manugp93/Nema_Clock/Media/IMG_20180118_104231.jpg

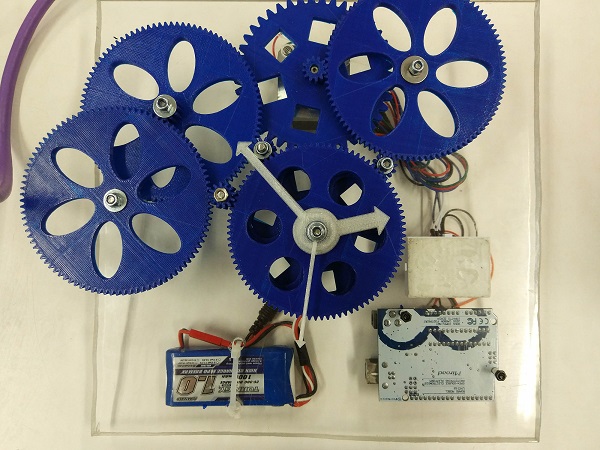
Media/IMG_20180118_104231.jpg
