manugp93/Nema_Clock/STL/12dientrs.stl

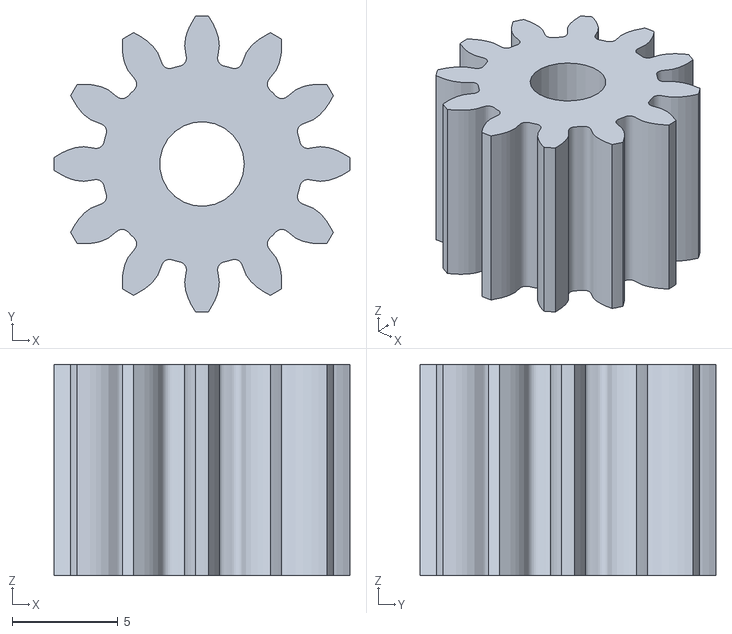
[picture p2: CAD file, 2018-02-03]
STL/12dientrs.stl
14.0 x 14.0 x 10.0
