manugp93/Nema_Clock/STL/90d.stl

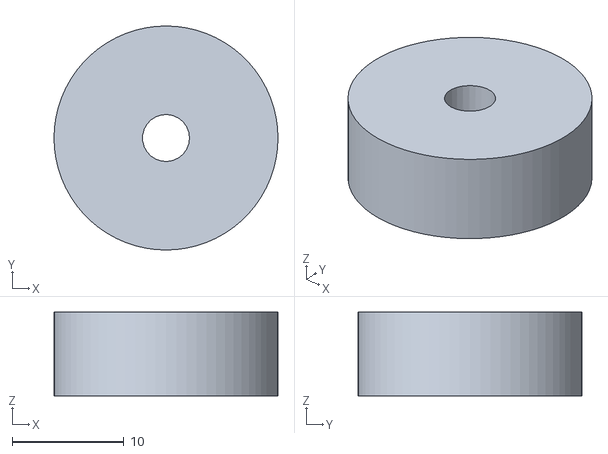
[picture p3: CAD file, 2018-02-03]
STL/90d.stl
20.0 x 20.0 x 7.50
