manugp93/Nema_Clock/STL/96dientes.stl

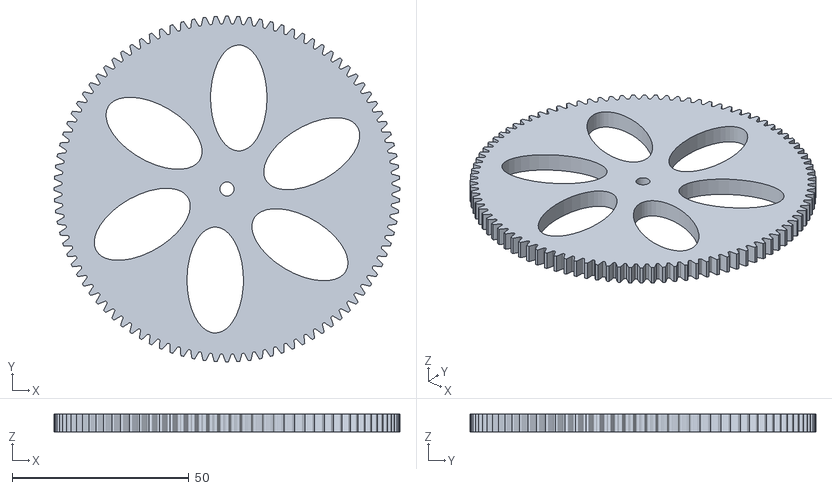
[picture p4: CAD file, 2018-02-03]
STL/96dientes.stl
98.0 x 98.0 x 5.00
