manugp93/Nema_Clock/STL/minutos.stl

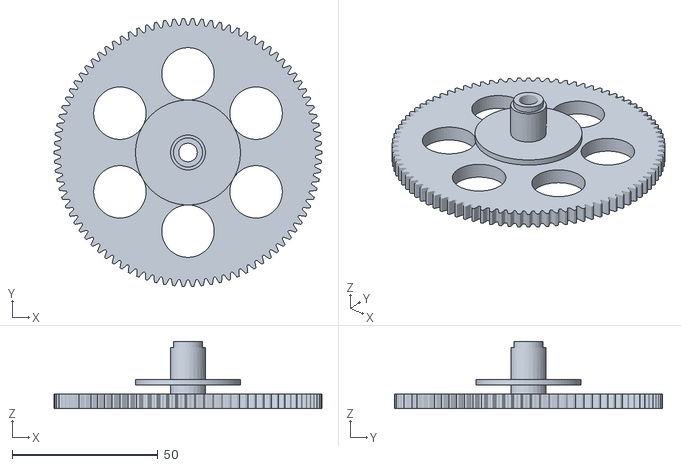
[picture p5: CAD file, 2018-02-03]
STL/minutos.stl
92.0 x 92.0 x 23.0
