manugp93/Nema_Clock/STL/nemagear.stl

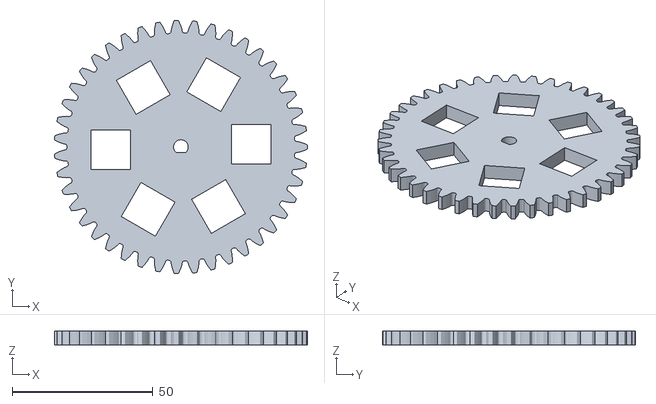
[picture p6: CAD file, 2018-02-03]
STL/nemagear.stl
89.9 x 90.0 x 5.00
