manugp93/Nema_Clock/STL/pivote2.stl

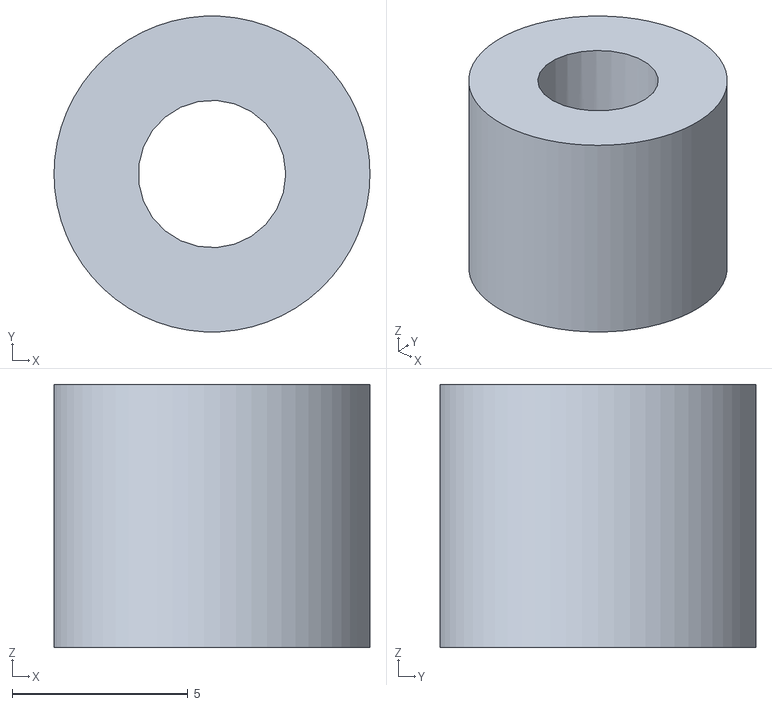
[picture p7: CAD file, 2018-02-03]
STL/pivote2.stl
9.00 x 8.99 x 7.50
