manugp93/Nema_Clock/STL/manecilla 1.stl

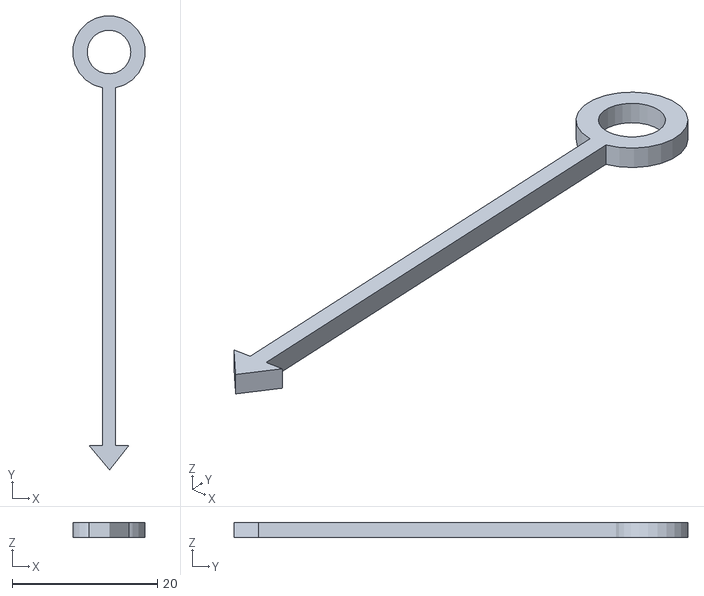
[picture p8: CAD file, 2018-02-03]
STL/manecilla 1.stl
9.95 x 62.5 x 2.00
