manugp93/Nema_Clock/STL/segundos.stl

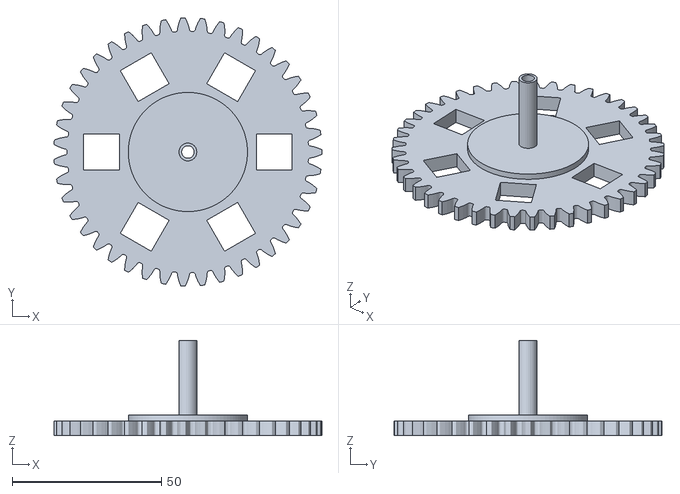
[picture p9: CAD file, 2018-02-03]
STL/segundos.stl
89.9 x 90.0 x 32.0
