manugp93/Nema_Clock/STL/horas.stl

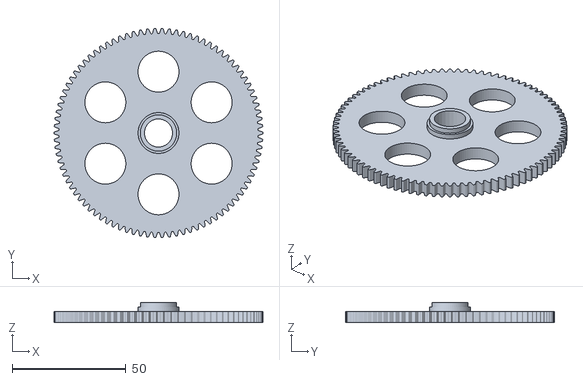
[picture p10: CAD file, 2018-02-03]
STL/horas.stl
92.0 x 92.0 x 9.00
