manugp93/Nema_Clock/STL/manecilla 3.stl

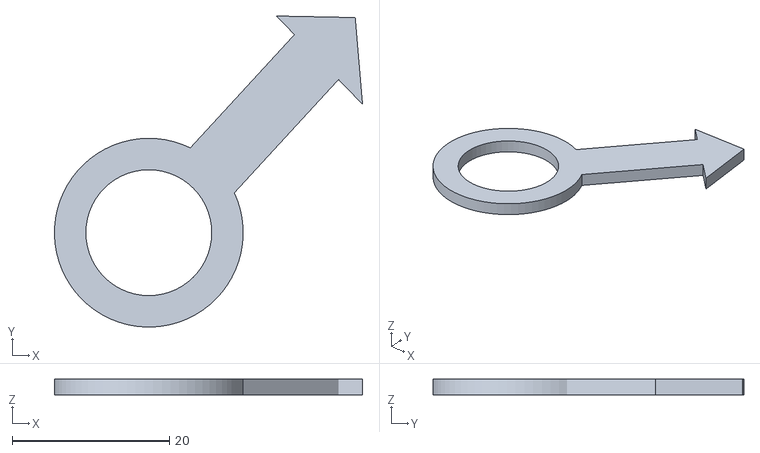
[picture p11: CAD file, 2018-02-03]
STL/manecilla 3.stl
39.2 x 39.5 x 2.00
