manugp93/Nema_Clock/STL/manecilla 2.stl

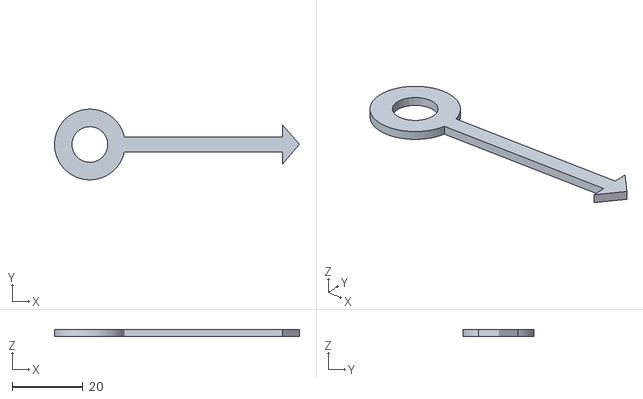
[picture p12: CAD file, 2018-02-03]
STL/manecilla 2.stl
69.3 x 20.0 x 2.00
